liqunmaster/Dust_HeavyHero/Device/motor/dm/dm_motor.hpp

#pragma once

#include <errno.h>
#include <stdint.h>
#include <string.h>

#include <zephyr/kernel.h>
#include <zephyr/sys/atomic.h>
#include <zephyr/sys/byteorder.h>

#include "bsp_fdcan.hpp"


enum DmControlMode {
    MOTOR_DM_CONTROL_METHOD_NORMAL_MIT         = 1,
    MOTOR_DM_CONTROL_METHOD_NORMAL_ANGLE_OMEGA = 2,
    MOTOR_DM_CONTROL_METHOD_NORMAL_OMEGA       = 3,
    MOTOR_DM_CONTROL_METHOD_NORMAL_EMIT        = 4,
};


struct DmMitLimits {
    float position;
    float velocity;
    float torque;
};


struct DmRxData {
    uint8_t motor_id;
    uint8_t status;
    uint16_t position;
    uint16_t velocity;
    uint16_t torque;
    uint8_t mos_temperature;
    uint8_t rotor_temperature;
};


struct DmData {
    float now_angle;
    float now_omega;
    float now_torque;
    float now_mos_temperature;
    float now_rotor_temperature;
    uint8_t status;
};

class dm_motor {
    public:

    int init(fdcan_device device, uint8_t motor_id, DmControlMode mode, DmMitLimits limits, fdcan_protocol protocol, uint16_t master_id = 0U);

    int set_mit(float position, float velocity, float kp, float kd, float torque);

    int set_position_velocity(float position, float max_velocity);

    int set_velocity(float velocity);

    int set_position_torque(float position, float max_velocity, float current_ratio);

    int build_control_frame(fdcan_frame &frame) const;

    int build_enable_frame(fdcan_frame &frame) const;

    int build_disable_frame(fdcan_frame &frame) const;

    int build_clear_error_frame(fdcan_frame &frame) const;

    int build_save_zero_frame(fdcan_frame &frame) const;

    int process_feedback(const fdcan_frame &frame);

    uint32_t get_feedback_count() const;

    DmRxData get_rx_data() const;

    DmData get_data() const;

    DmControlMode get_mode() const;

    
    fdcan_device device() const { return device_; }
    
    uint8_t motor_id() const { return motor_id_; }
    
    uint32_t feedback_id() const { return master_id_; }
    
    fdcan_protocol feedback_protocol() const { return protocol_; }
    uint32_t control_frame_id() const;

    private:
    friend int fdcan_port_request_mode(dm_motor &motor, DmControlMode mode);

    int build_mode_frame(DmControlMode mode, fdcan_frame &frame) const;

    int mark_mode_request(DmControlMode mode);

    static bool valid_mode(DmControlMode mode);

    static uint16_t control_id(uint8_t motor_id, DmControlMode mode);

    static uint16_t encode(float value, float minimum, float maximum, uint16_t maximum_raw);

    static float decode(uint16_t raw, float limit, uint16_t maximum_raw);

    static void write_f32(uint8_t *dst, float value);

    static void write_u16(uint8_t *dst, uint16_t value);

    int build_command_frame(uint8_t command, fdcan_frame &frame) const;

    static int make_frame(uint16_t id, const uint8_t *data, uint8_t length, fdcan_frame &frame);

    
    fdcan_device device_ = FDCAN_DEVICE_COUNT;

    
    uint8_t motor_id_ = 0U;

    
    uint16_t master_id_ = 0U;

    
    DmControlMode mode_ = DmControlMode::MOTOR_DM_CONTROL_METHOD_NORMAL_MIT;

    
    fdcan_protocol protocol_ = FDCAN_PROTOCOL_CLASSIC;

    
    DmControlMode requested_mode_ = DmControlMode::MOTOR_DM_CONTROL_METHOD_NORMAL_MIT;

    
    bool mode_change_pending_ = false;

    
    bool initialized_ = false;

    
    DmMitLimits limits_{};

    
    uint8_t tx_data_[8]{};

    
    uint8_t tx_length_ = 0U;

    
    DmRxData rx_data_{};

    
    DmData data_{};

    
    mutable struct k_spinlock lock_{};

    
    atomic_t feedback_count_{};

};
