liqunmaster/Dust_HeavyHero/Device/imu/icm42688p_hxy/icm42688p_hxy.cpp

#include "icm42688p_hxy.hpp"

#include <string.h>

#include <zephyr/device.h>
#include <zephyr/devicetree.h>

namespace {


#define IMU_NODE DT_ALIAS(imu_spi)

    
    K_SEM_DEFINE(data_ready_sem, 0, 1);

    
    const gpio_dt_spec int1 = GPIO_DT_SPEC_GET(IMU_NODE, int1_gpios);
    const gpio_dt_spec int2 = GPIO_DT_SPEC_GET(IMU_NODE, int2_gpios);

    

    int16_t read_i16_be(const uint8_t *data) {
        const uint16_t value = (static_cast<uint16_t>(data[0]) << 8U) |
        static_cast<uint16_t>(data[1]);
        return static_cast<int16_t>(value);
    }

    

    void data_ready_callback(void *) {
        k_sem_give(&data_ready_sem);
    }

}



int icm42688phxy::read_registers(uint8_t address, uint8_t *data, size_t length) {
    if (data == nullptr || length == 0U || length + 1U > SPI_BUFFER_SIZE ||
    address > 0x7FU) {
        return -EINVAL;
    }

    uint8_t tx[SPI_BUFFER_SIZE]{};
    uint8_t rx[SPI_BUFFER_SIZE]{};
    tx[0] = static_cast<uint8_t>(address | ICM42688PHXY_SPI_READ_BIT);
    const int ret = bsp_spi_transceive(&spi_, tx, rx, length + 1U);
    if (ret != 0) {
        return ret;
    }
    for (size_t index = 0U; index < length; ++index) {
        data[index] = rx[index + 1U];
    }
    return 0;
}



int icm42688phxy::write_register(uint8_t address, uint8_t value) {
    if (address > 0x7FU) {
        return -EINVAL;
    }
    const uint8_t tx[2] = {address, value};
    uint8_t rx[sizeof(tx)]{};
    return bsp_spi_transceive(&spi_, tx, rx, sizeof(tx));
}



int icm42688phxy::configure_register(uint8_t address, uint8_t value,
uint32_t settle_ms) {
    int ret = write_register(address, value);
    if (ret != 0) {
        return ret;
    }
    if (settle_ms != 0U) {
        k_sleep(K_MSEC(settle_ms));
    }

    uint8_t readback = 0U;
    ret              = read_registers(address, &readback, 1U);
    return ret != 0 ? ret : (readback == value ? 0 : -EIO);
}



int icm42688phxy::init() {
    if (initialized_) {
        return 0;
    }
    if (!device_is_ready(int1.port) || !device_is_ready(int2.port)) {
        return -ENODEV;
    }

    int ret = bsp_spi_init(&spi_, DEVICE_DT_GET(DT_BUS(IMU_NODE)),
                           static_cast<uint16_t>(DT_REG_ADDR(IMU_NODE)),
                           DT_PROP(IMU_NODE, spi_max_frequency),
                           SPI_MODE_CPOL | SPI_MODE_CPHA);
    if (ret != 0) {
        return ret;
    }

    k_busy_wait(3000U);
    if (write_register(ICM42688PHXY_REG_SOFT_RST,
    ICM42688PHXY_SOFT_RST_VALUE) != 0) {
        return -EIO;
    }
    k_sleep(K_MSEC(50));

    uint8_t who_am_i = 0U;
    if (read_registers(ICM42688PHXY_REG_WHO_AM_I, &who_am_i, 1U) != 0 ||
    who_am_i != ICM42688PHXY_WHO_AM_I_VALUE) {
        return -ENODEV;
    }

    if (configure_register(ICM42688PHXY_REG_COM_CFG,
                           ICM42688PHXY_COM_CFG_BDU_AUTO_INC, 1U) != 0 ||
        configure_register(ICM42688PHXY_REG_ACC_CONF,
                           ICM42688PHXY_ACC_CONF_200HZ, 1U) != 0 ||
        configure_register(ICM42688PHXY_REG_ACC_RANGE,
                           ICM42688PHXY_ACC_RANGE_16G, 1U) != 0 ||
        configure_register(ICM42688PHXY_REG_GYR_CONF,
                           ICM42688PHXY_GYR_CONF_200HZ, 1U) != 0 ||
        configure_register(ICM42688PHXY_REG_GYR_RANGE,
    ICM42688PHXY_GYR_RANGE_2000DPS, 1U) != 0) {
        return -EIO;
    }

    if (write_register(ICM42688PHXY_REG_PWR_CTRL,
    ICM42688PHXY_PWR_OFF) != 0) {
        return -EIO;
    }
    k_sleep(K_MSEC(2U));
    if (configure_register(ICM42688PHXY_REG_GYR_CONF,
                           ICM42688PHXY_GYR_CONF_NOISE_OPT, 1U) != 0 ||
        write_register(ICM42688PHXY_REG_PWR_CTRL,
    ICM42688PHXY_PWR_ALL_ON) != 0) {
        return -EIO;
    }
    k_sleep(K_MSEC(50U));

    uint8_t status = 0U;
    if (read_registers(ICM42688PHXY_REG_DATA_STAT, &status, 1U) != 0 ||
        (status & (ICM42688PHXY_DATA_STAT_GYR_CONF_ERR |
    ICM42688PHXY_DATA_STAT_ACC_CONF_ERR)) != 0U) {
        return -EIO;
    }

    ret = bsp_gpio_exti_init(&int1_irq_, &int1, GPIO_INT_EDGE_TO_ACTIVE,
                             data_ready_callback, nullptr);
    if (ret != 0) {
        return ret;
    }
    ret = configure_register(ICM42688PHXY_REG_INT_CFG1,
                             ICM42688PHXY_INT1_DRDY_ACCEL, 1U);
    if (ret != 0) {
        return ret;
    }

    initialized_ = true;
    return 0;
}



int icm42688phxy::wait_data_ready(k_timeout_t timeout) {
    if (!initialized_) {
        return -ENODEV;
    }
    return k_sem_take(&data_ready_sem, timeout);
}



int icm42688phxy::read_sample(icm42688phxy_sample &sample) {
    if (!initialized_) {
        return -ENODEV;
    }

    constexpr size_t temp_offset =
    ICM42688PHXY_REG_TEMP_H - ICM42688PHXY_REG_DATA_STAT;
    constexpr size_t burst_length = temp_offset + ICM42688PHXY_TEMP_FRAME_SIZE;
    uint8_t frame[burst_length]{};
    int ret = read_registers(ICM42688PHXY_REG_DATA_STAT, frame, burst_length);
    if (ret != 0) {
        return ret;
    }
    const uint8_t status = frame[0];
    if ((status & (ICM42688PHXY_DATA_STAT_GYR_CONF_ERR |
    ICM42688PHXY_DATA_STAT_ACC_CONF_ERR)) != 0U) {
        return -EIO;
    }
    constexpr uint8_t ready_mask = ICM42688PHXY_DATA_STAT_ACC_READY |
    ICM42688PHXY_DATA_STAT_GYR_READY;
    if ((status & ready_mask) != ready_mask) {
        return -EAGAIN;
    }

    uint8_t decoded_frame[frame_size]{};
    memcpy(decoded_frame, &frame[1U], ICM42688PHXY_SENSOR_FRAME_SIZE);
    memcpy(&decoded_frame[ICM42688PHXY_SENSOR_FRAME_SIZE],
           &frame[temp_offset], ICM42688PHXY_TEMP_FRAME_SIZE);
    return decode_frame(decoded_frame, frame_size, sample);
}



int icm42688phxy::decode_frame(const uint8_t *frame, size_t length,
icm42688phxy_sample &sample) {
    if (frame == nullptr || length != frame_size) {
        return -EINVAL;
    }

    icm42688phxy_sample decoded{};
    for (size_t axis = 0U; axis < 3U; ++axis) {
        decoded.accel_raw[axis] = read_i16_be(&frame[axis * 2U]);
        decoded.gyro_raw[axis] = read_i16_be(&frame[6U + axis * 2U]);
    }
    decoded.temperature_raw = read_i16_be(&frame[ICM42688PHXY_SENSOR_FRAME_SIZE]);
    sample                  = decoded;
    return 0;
}
