liqunmaster/Dust_HeavyHero/Device/imu/icm42688p_hxy/icm42688p_hxy_reg.h

#pragma once

#include <stdint.h>

#define ICM42688PHXY_REG_WHO_AM_I            0x01U   
#define ICM42688PHXY_REG_COM_CFG             0x05U   
#define ICM42688PHXY_REG_INT_CFG1            0x06U   
#define ICM42688PHXY_REG_DATA_STAT           0x0BU   
#define ICM42688PHXY_REG_ACC_XH              0x0CU   
#define ICM42688PHXY_REG_TEMP_H              0x22U   
#define ICM42688PHXY_REG_ACC_CONF            0x40U   
#define ICM42688PHXY_REG_ACC_RANGE           0x41U   
#define ICM42688PHXY_REG_GYR_CONF            0x42U   
#define ICM42688PHXY_REG_GYR_RANGE           0x43U   
#define ICM42688PHXY_REG_SOFT_RST            0x4AU   
#define ICM42688PHXY_REG_PWR_CTRL            0x7DU   

#define ICM42688PHXY_WHO_AM_I_VALUE          0x6AU   
#define ICM42688PHXY_SPI_READ_BIT            0x80U   
#define ICM42688PHXY_COM_CFG_BDU_AUTO_INC    0x50U   
#define ICM42688PHXY_SOFT_RST_VALUE          0xA5U   
#define ICM42688PHXY_PWR_OFF                 0x00U   
#define ICM42688PHXY_PWR_ALL_ON              0x0FU   
#define ICM42688PHXY_ACC_CONF_200HZ          0xA9U   
#define ICM42688PHXY_GYR_CONF_200HZ          0xA9U   
#define ICM42688PHXY_GYR_CONF_NOISE_OPT      0xC9U   
#define ICM42688PHXY_ACC_RANGE_16G           0x03U   
#define ICM42688PHXY_GYR_RANGE_2000DPS       0x00U   
#define ICM42688PHXY_INT1_DRDY_ACCEL         0x01U   

#define ICM42688PHXY_DATA_STAT_GYR_CONF_ERR  (1U << 5U)  
#define ICM42688PHXY_DATA_STAT_ACC_CONF_ERR  (1U << 4U)  
#define ICM42688PHXY_DATA_STAT_GYR_READY     (1U << 1U)  
#define ICM42688PHXY_DATA_STAT_ACC_READY     (1U << 0U)  

#define ICM42688PHXY_SENSOR_FRAME_SIZE       12U  
#define ICM42688PHXY_TEMP_FRAME_SIZE         2U   
