liqunmaster/Dust_HeavyHero/Module/input/input_parser.hpp

#pragma once

#include <string.h>

#include "dt7.hpp"
#include "vt02.hpp"
#include "vt03.hpp"
#include "remote_types.hpp"


struct input_sample {
    remote_protocol protocol;
    remote_uart_source source;
    uint32_t timestamp_ms;
    union {
        dt7_sample dt7_data;
        vt02_sample vt02_data;
        vt03_sample vt03_data;
    };
};


class input_stream_parser {
public:
    using sample_callback = void (*)(const input_sample &, void *);

    
    explicit input_stream_parser(remote_uart_source source) : source_(source) {}

    void reset();

    void feed(const uint8_t *data, size_t length, uint32_t timestamp_ms, sample_callback callback, void *context);

private:
    
    enum class parse_state : uint8_t { header, vt03_header, vt02_header, frame };

    void consume(size_t count);

    void try_decode(uint32_t timestamp_ms, sample_callback callback, void *context);

    
    remote_uart_source source_;

    
    parse_state state_ = parse_state::header;

    
    remote_protocol candidate_ = remote_protocol::none;

    
    size_t expected_length_ = 0U;

    
    size_t length_ = 0U;
    
    
    uint8_t buffer_[128]{};
};
